AIROB-Lab/AIROB-Active-Knee-Orthosis/src/drawing/Stator_Drawing.PNG

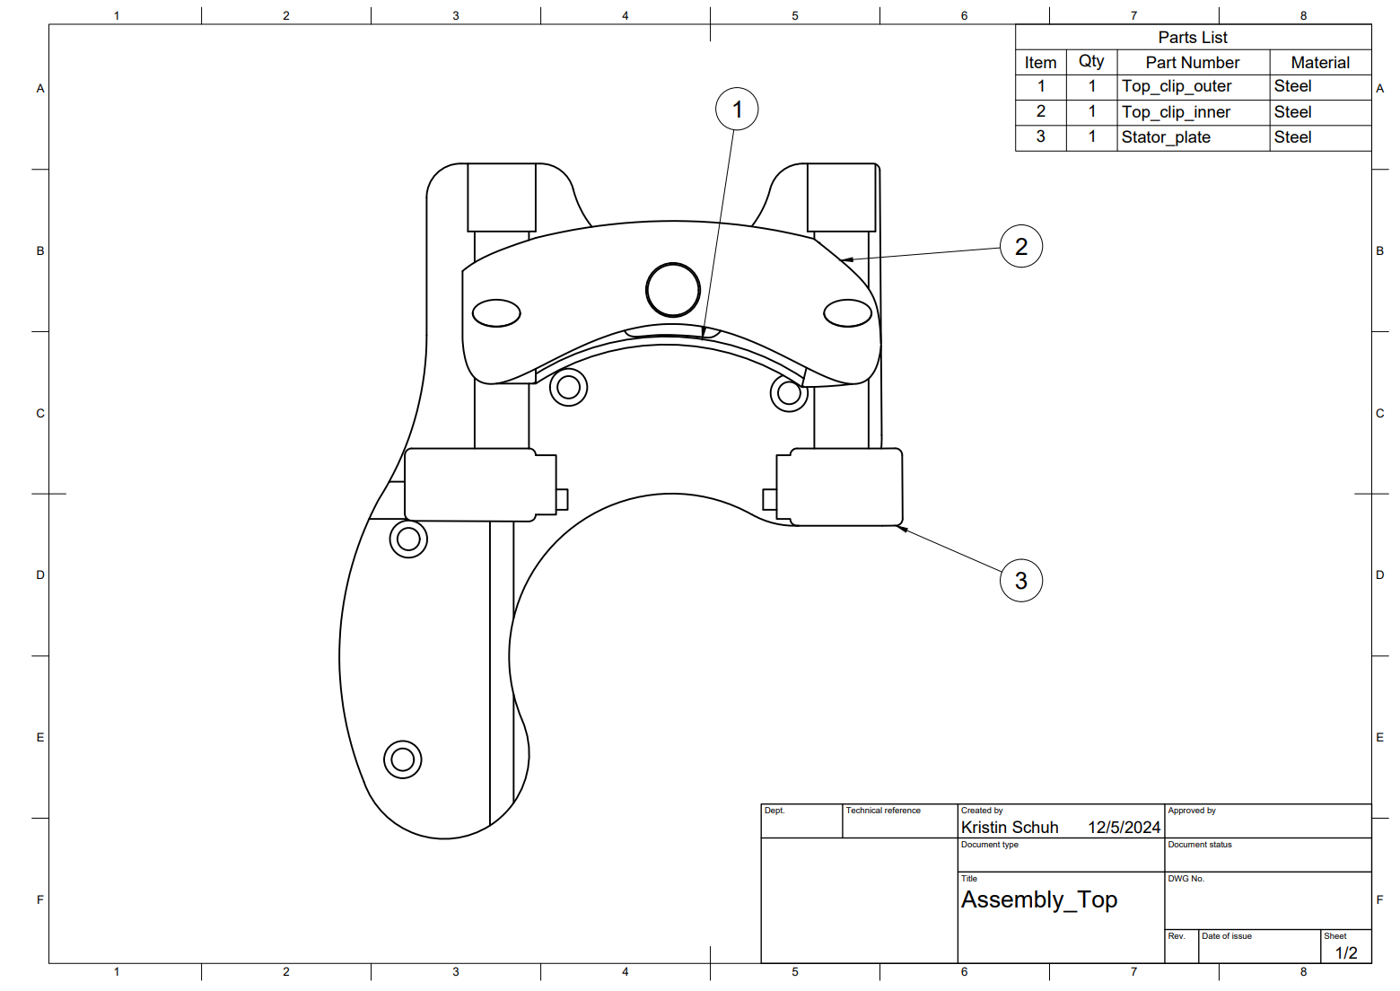
src/drawing/Stator_Drawing.PNG
