AIROB-Lab/AIROB-Active-Knee-Orthosis/src/assembly/Stator_assembly.step

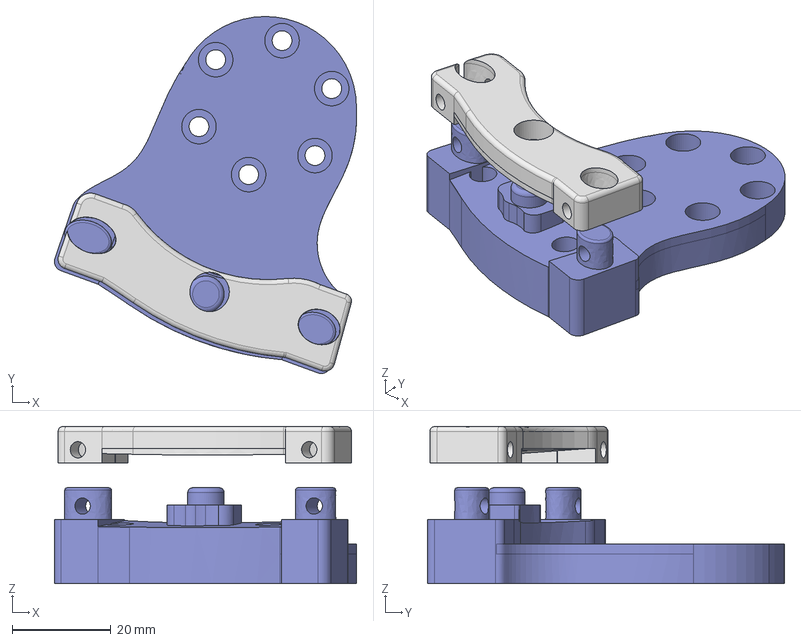
[picture p3: CAD file, 2024-12-05]
src/assembly/Stator_assembly.step
61.3 x 72.4 x 31.9 mm
Outer
Inner
