AIROB-Lab/AIROB-Active-Knee-Orthosis/src/assembly/Rotor_assembly.step

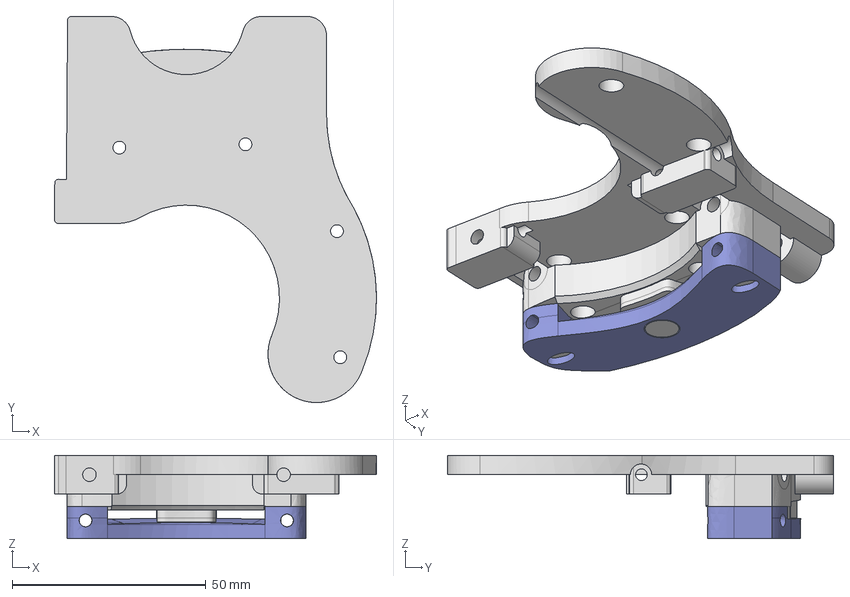
[picture p4: CAD file, 2024-12-05]
src/assembly/Rotor_assembly.step
83.0 x 99.6 x 21.5 mm
Top_clip_outer
Top_clip_inner
Stator_plate
