AIROB-Lab/AIROB-Active-Knee-Orthosis/src/Stator_Plate.step

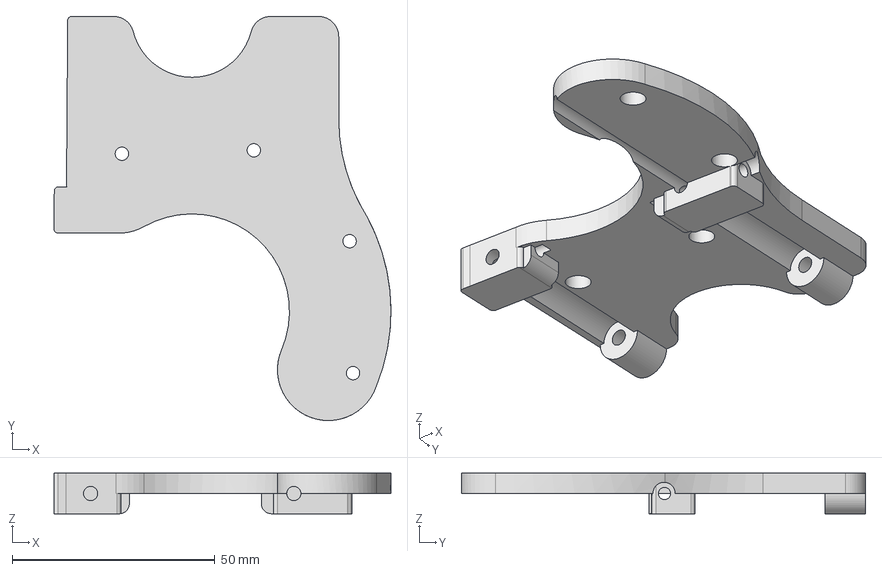
[picture p6: CAD file, 2024-12-05]
src/Stator_Plate.step
83.0 x 99.6 x 10.0 mm
