AIROB-Lab/AIROB-Active-Knee-Orthosis/src/Rotor_Clip.step

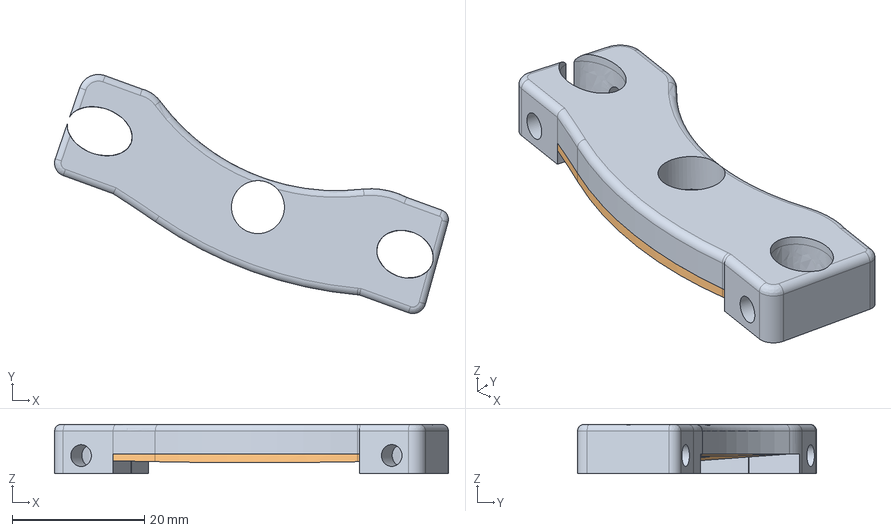
[picture p7: CAD file, 2024-12-05]
src/Rotor_Clip.step
59.5 x 36.1 x 7.45 mm
Outer
Inner
