AIROB-Lab/AIROB-Active-Knee-Orthosis/src/Stator_Clip.step

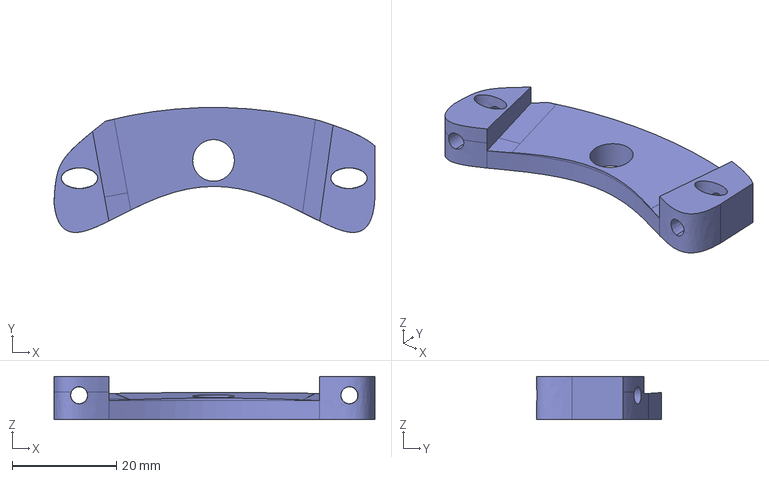
[picture p8: CAD file, 2024-12-05]
src/Stator_Clip.step
61.7 x 24.0 x 8.35 mm
