AIROB-Lab/AIROB-Active-Knee-Orthosis/src/Stator_Sledge.step

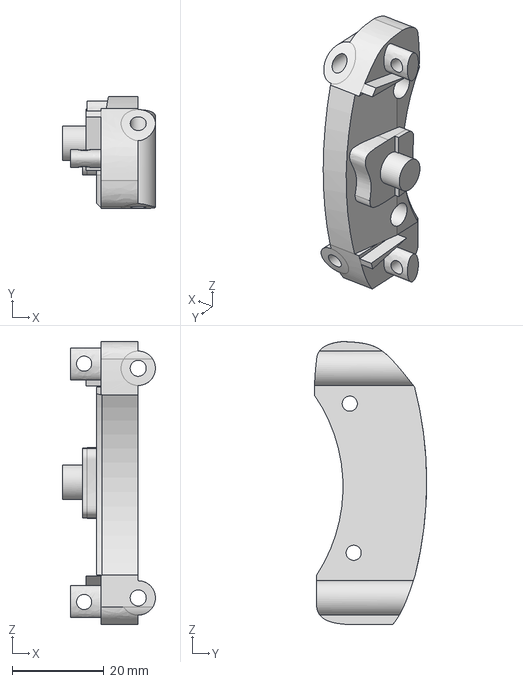
[picture p9: CAD file, 2024-12-05]
src/Stator_Sledge.step
20.2 x 24.5 x 61.7 mm
