AIROB-Lab/AIROB-Active-Knee-Orthosis/src/drawing/Assembly_Drawing.pdf

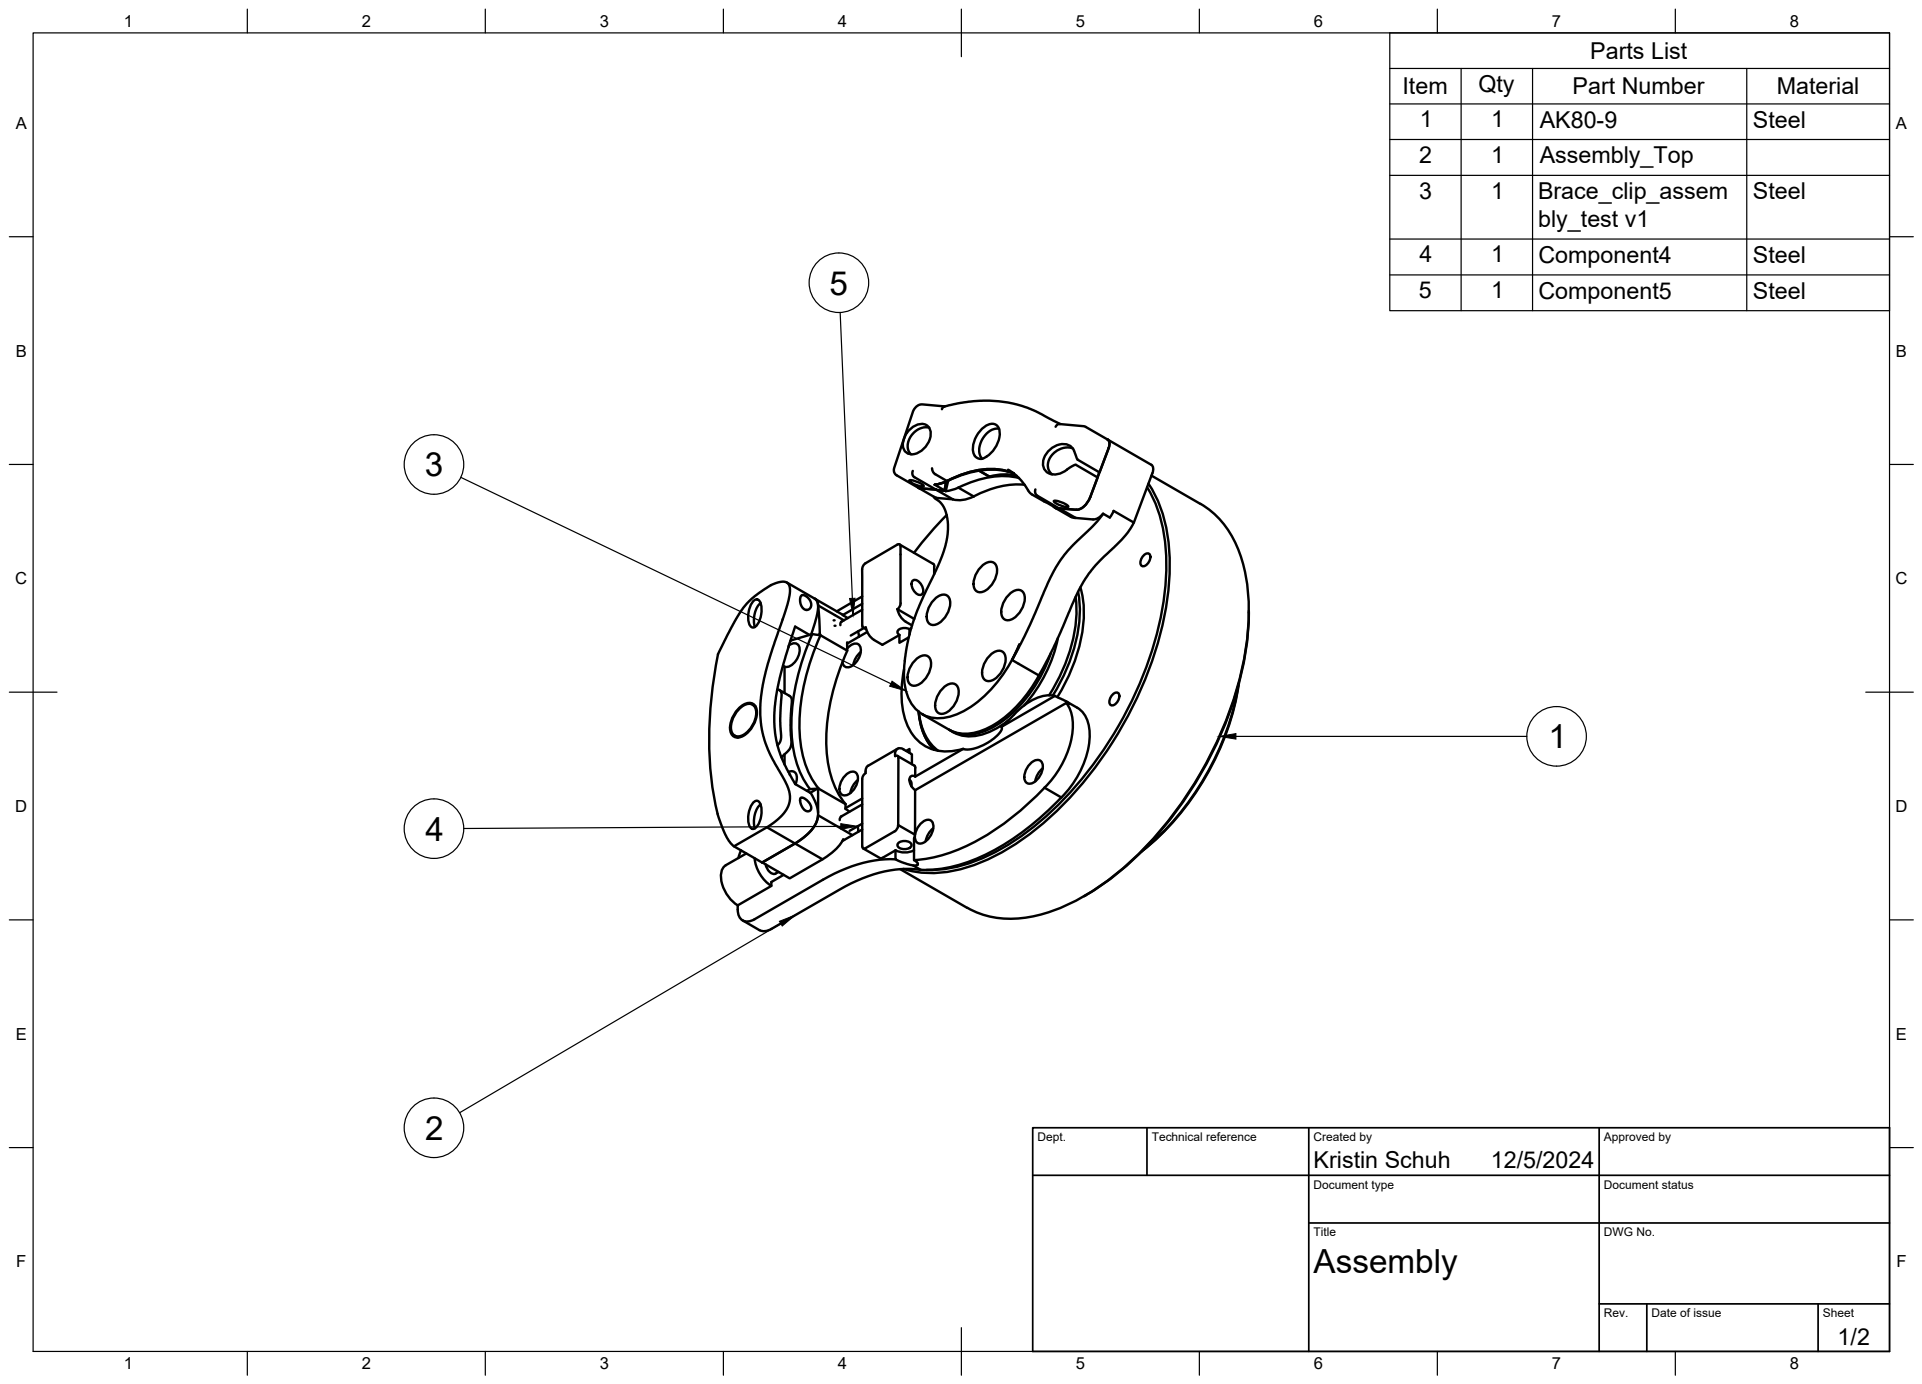
[picture p10: page 1]
Title; DWG No.; Rev.; Date of issue; Sheet; Parts List

Item | Qty | Part Number | Material
1 | 1 | AK80-9 | Steel
2 | 1 | Assembly_Top
3 | 1 | Brace_clip_assem bly_test v1 | Steel

4 | 1 | Component4 | Steel
5 | 1 | Component5 | Steel

Dept. | Technical reference | Created by Kristin Schuh 12/5/2024 | Approved by

Document type | Document status

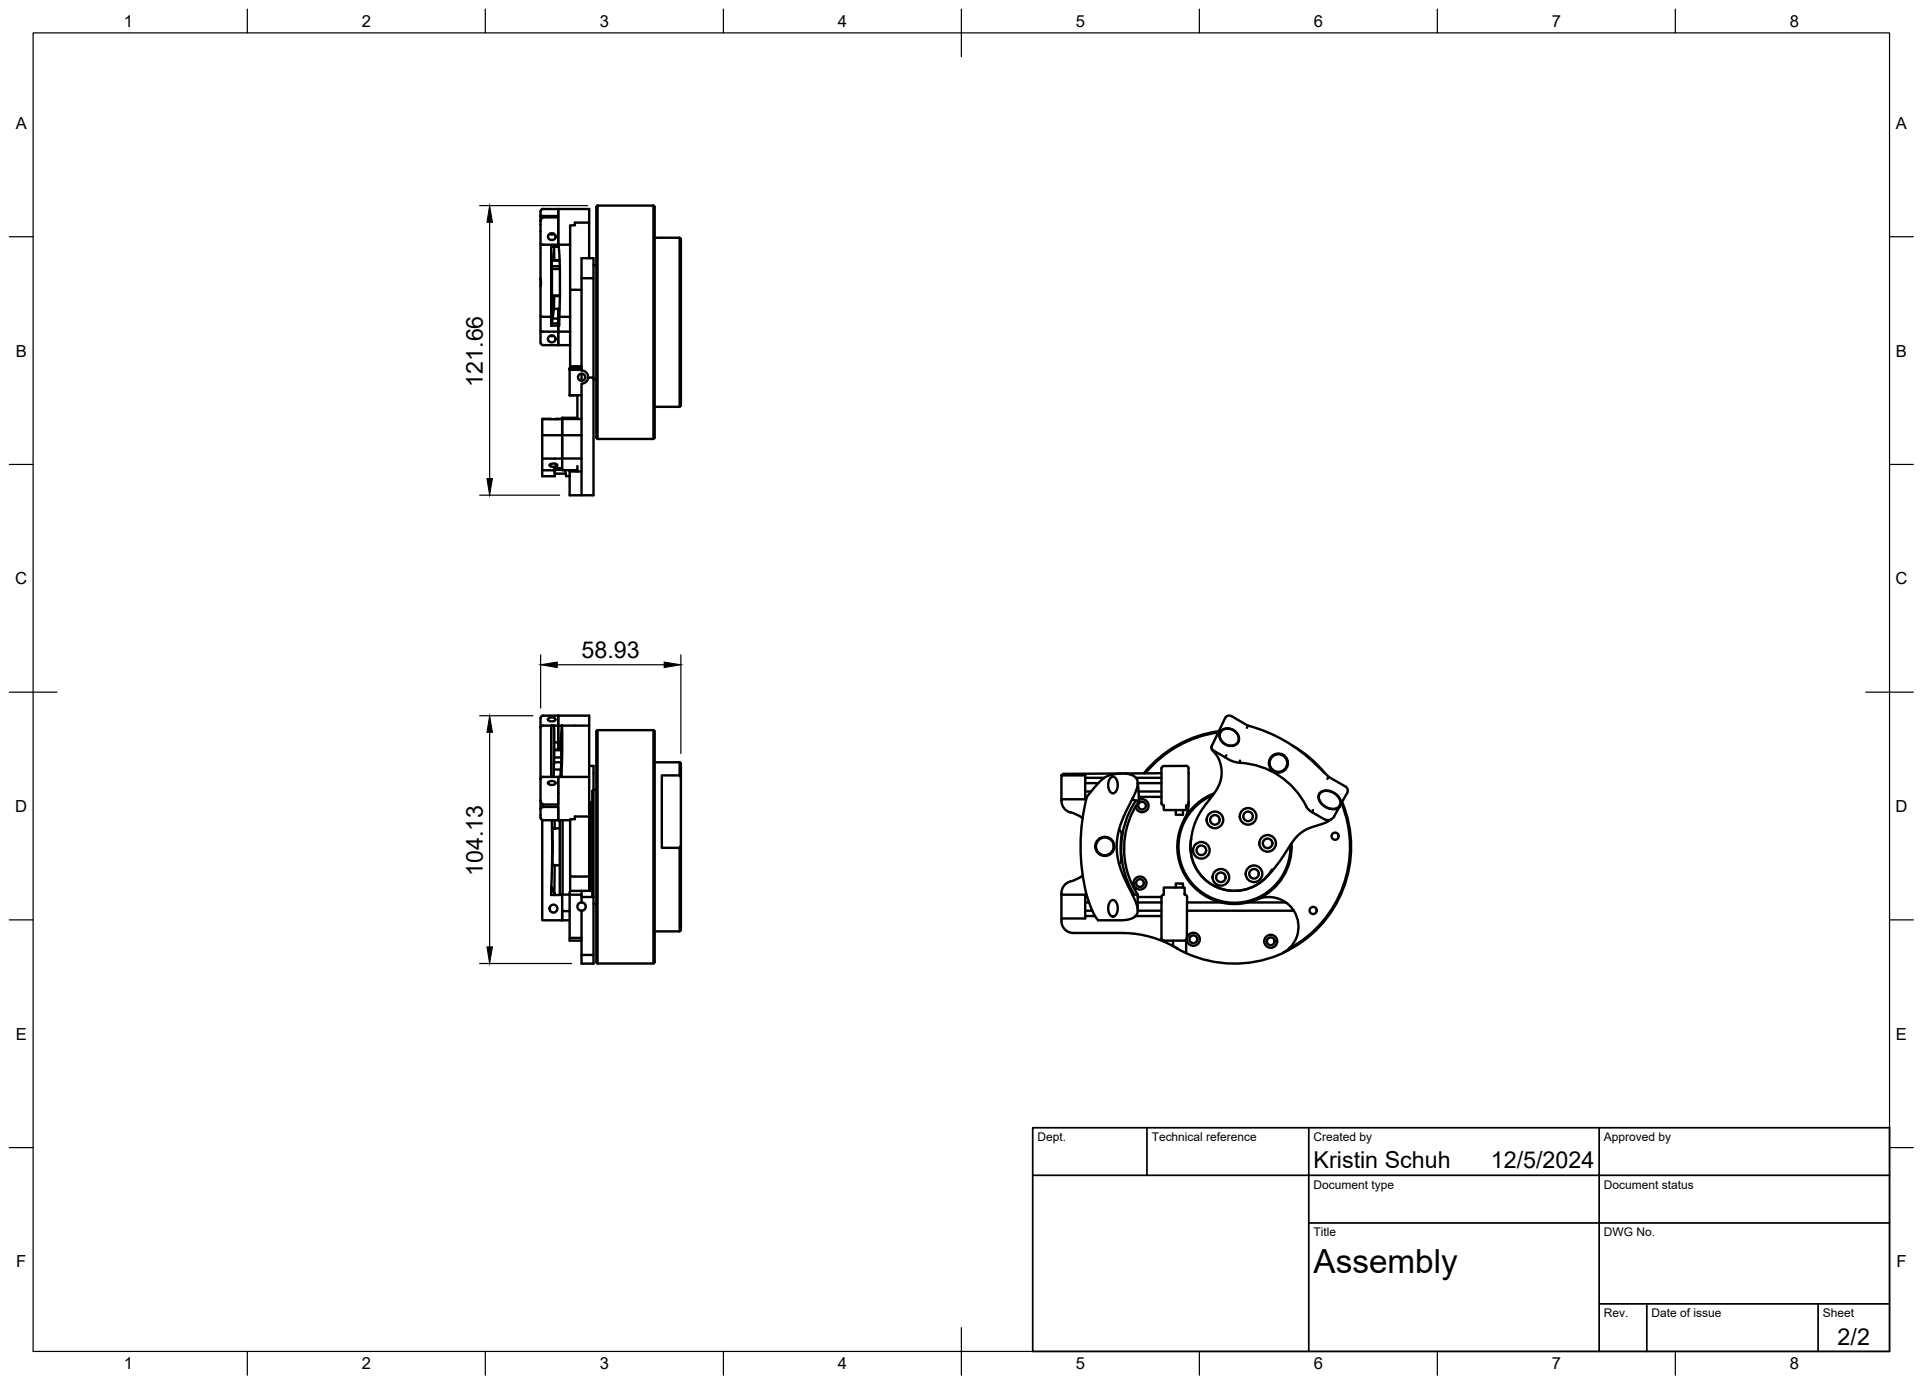
[picture p11: page 2]
Title; DWG No.; Rev.; Date of issue; Sheet; Kristin Schuh 104.13

Dept. | Technical reference | Created by 12/5/2024 | Approved by

Document type | Document status
