AIROB-Lab/AIROB-Active-Knee-Orthosis/src/drawing/Stator_Drawing.pdf

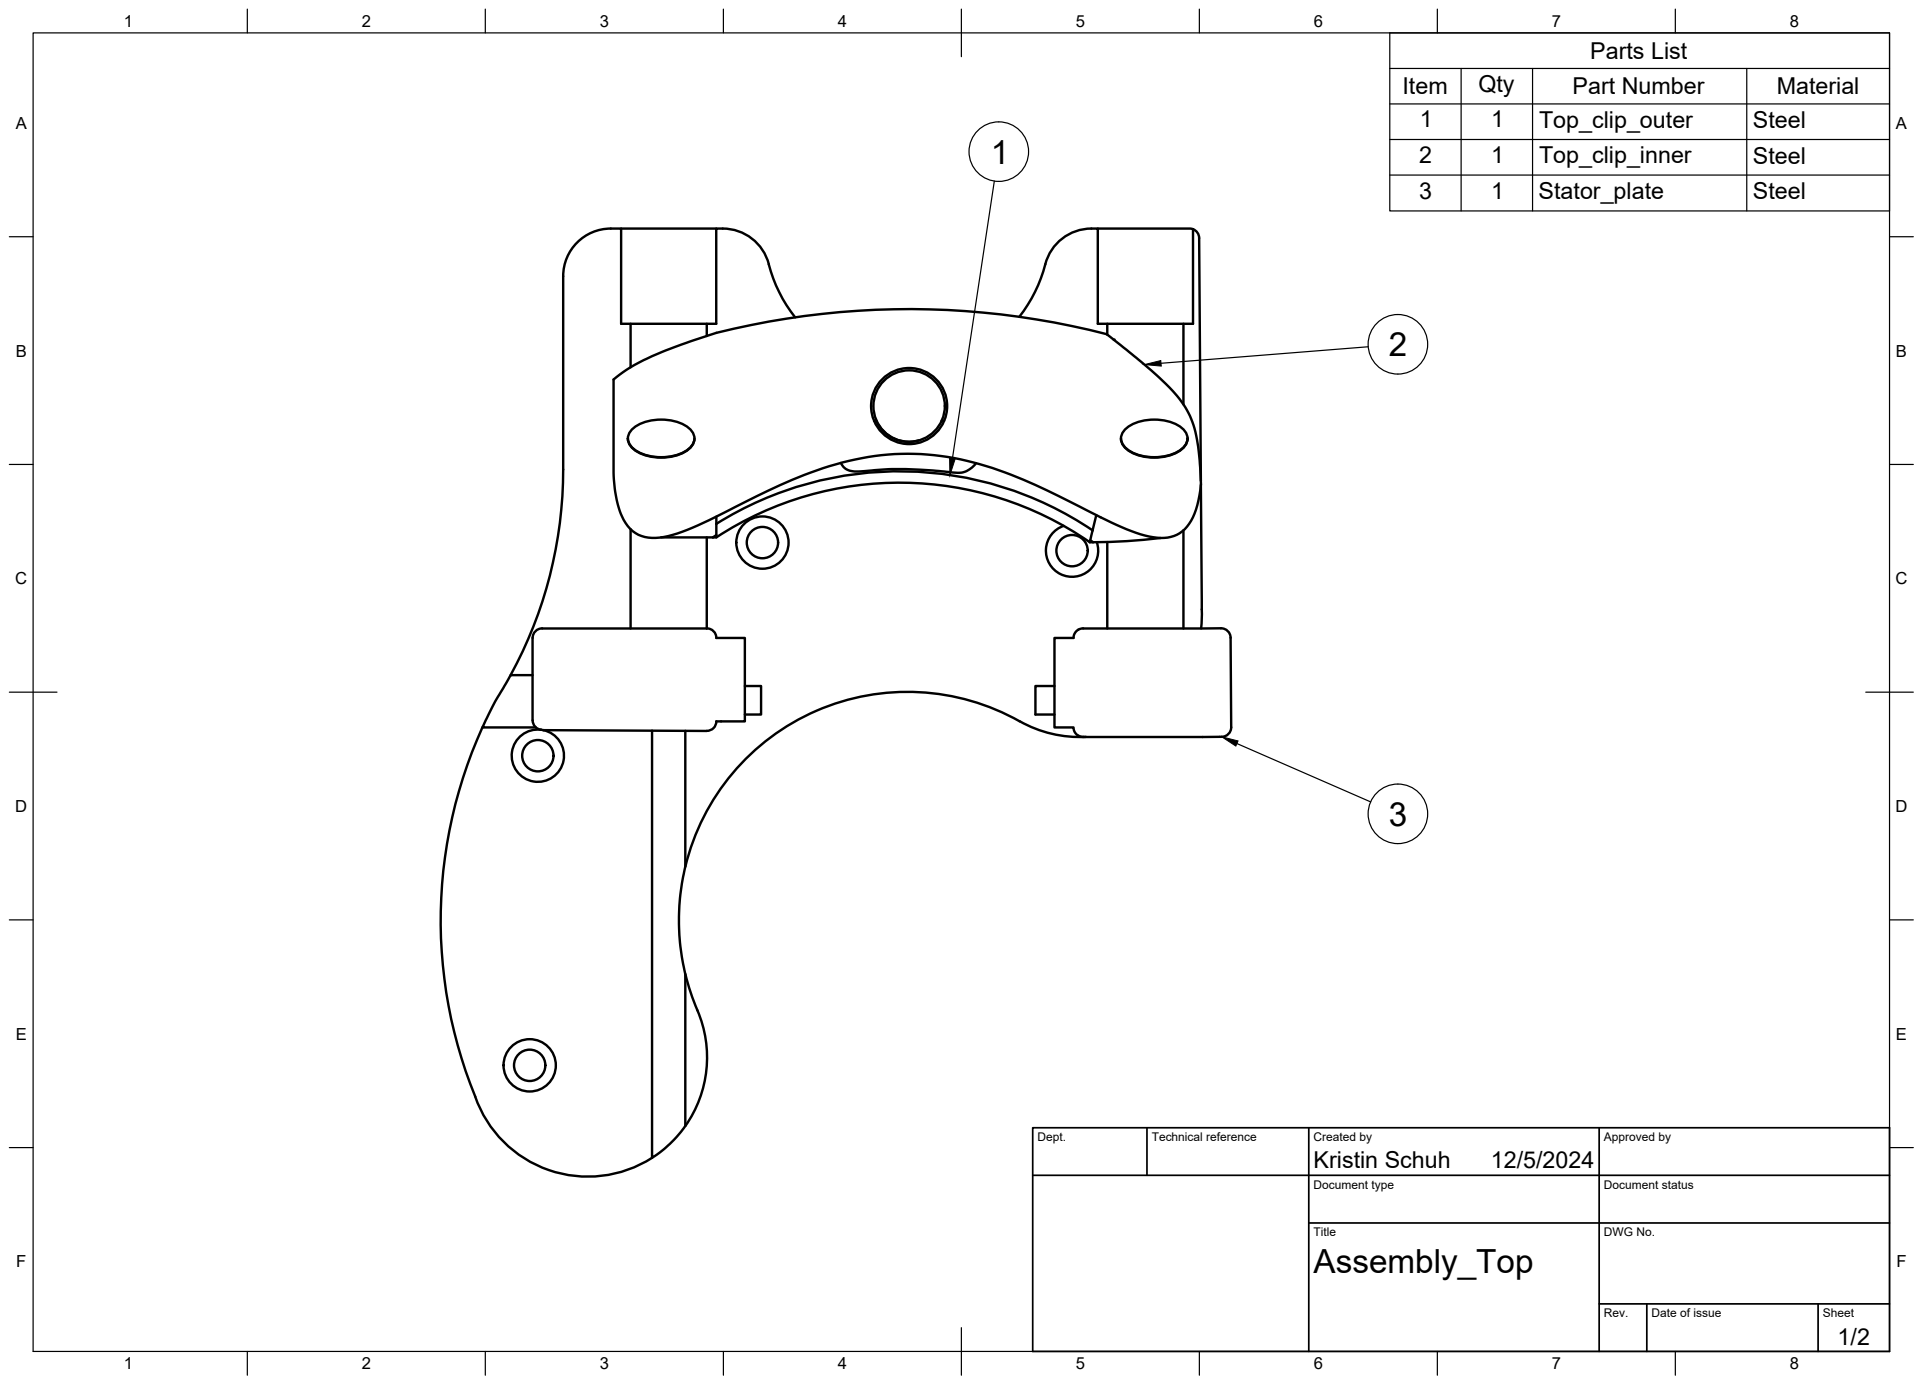
[picture p12: page 1]
Title; DWG No.; Rev.; Date of issue; Sheet; Parts List

Item | Qty | Part Number | Material
1 | 1 | Top_clip_outer | Steel
2 | 1 | Top_clip_inner | Steel
3 | 1 | Stator_plate | Steel

Dept. | Technical reference | Created by Kristin Schuh 12/5/2024 | Approved by

Document type | Document status

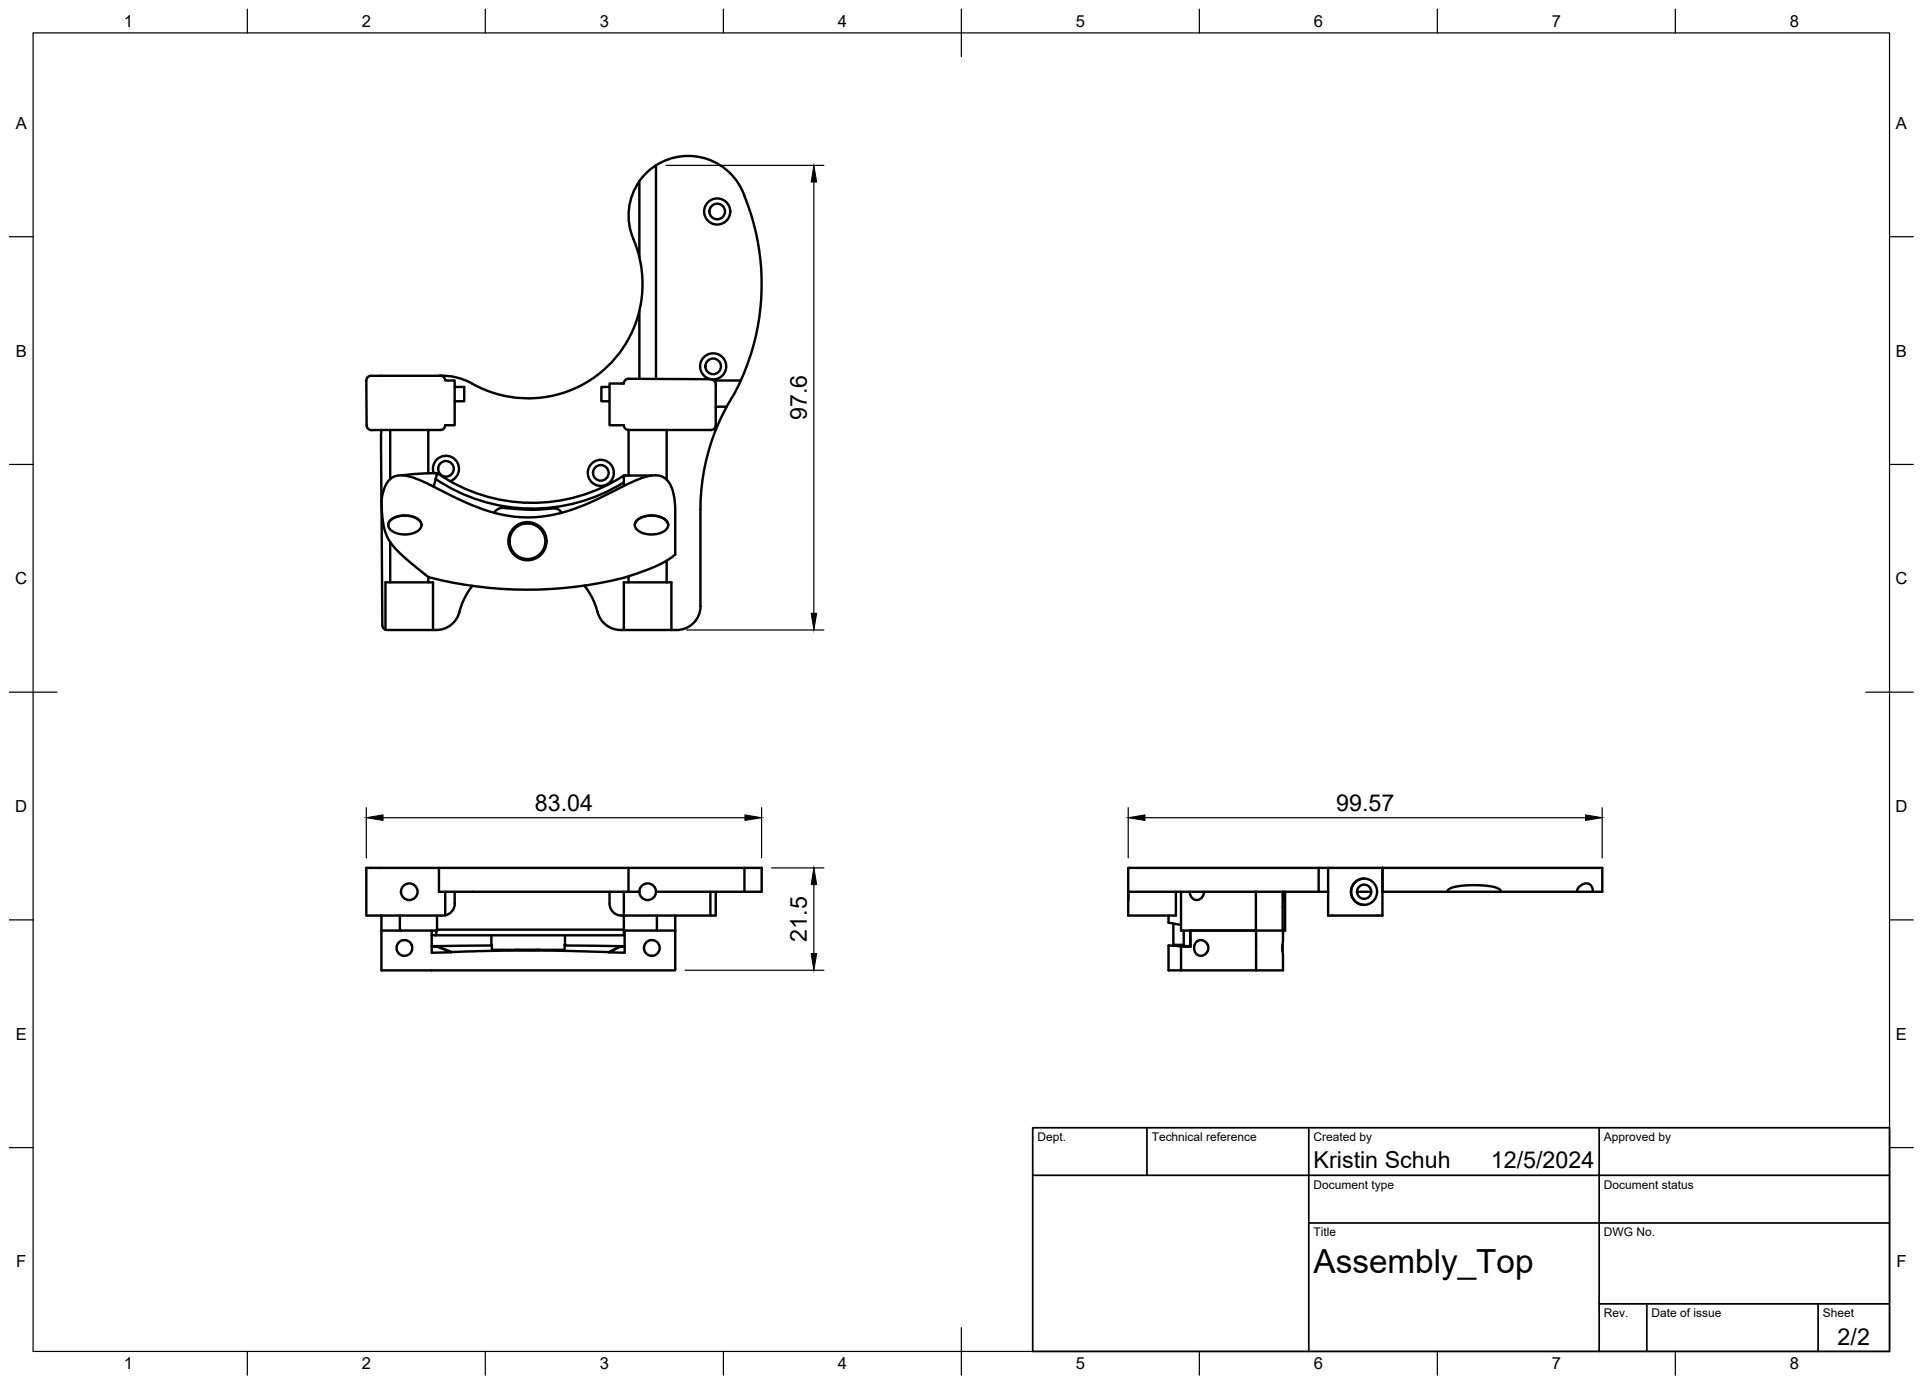
[picture p13: page 2]
Title; DWG No.; Rev.; Date of issue; Sheet

Dept. | Technical reference | Created by Kristin Schuh 12/5/2024 | Approved by

Document type | Document status
