AIROB-Lab/AIROB-Active-Knee-Orthosis/images/Assembly_Render1.png

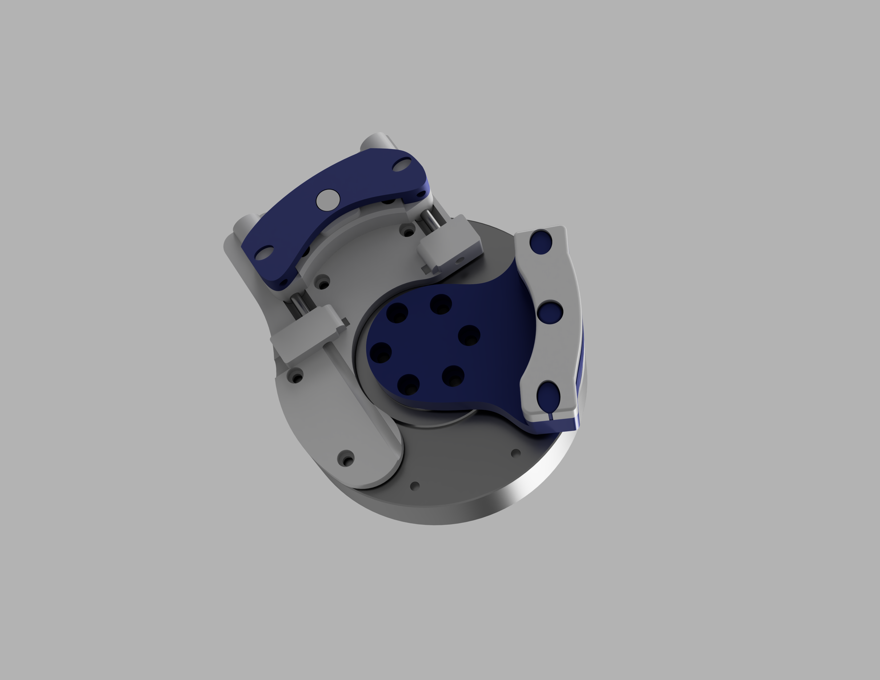
images/Assembly_Render1.png
